paulvee/100MHz-Differential-Probe/Diff Probe Front detail.jpg

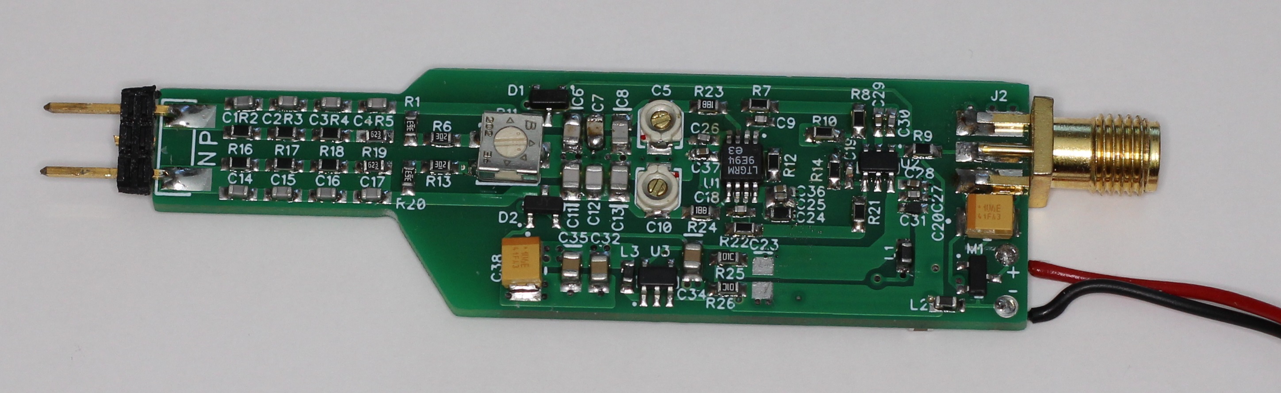
Diff Probe Front detail.jpg
