paulvee/100MHz-Differential-Probe/Diff Probe Back.jpg

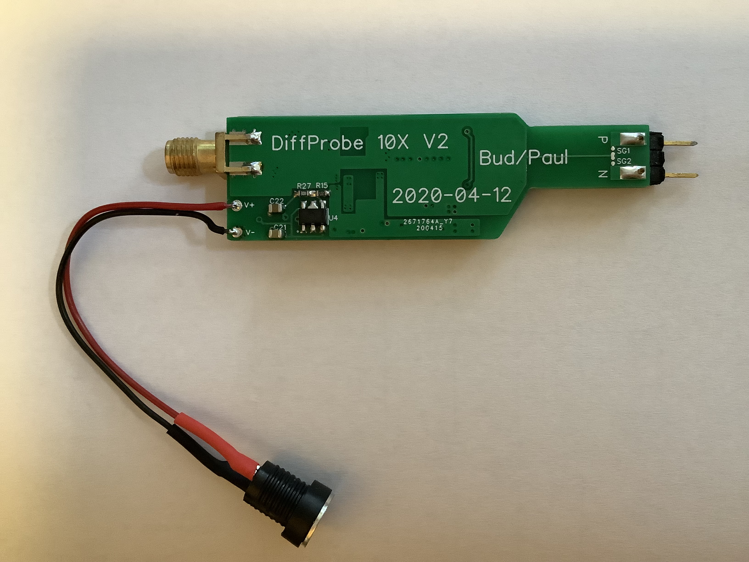
Diff Probe Back.jpg
