paulvee/100MHz-Differential-Probe/README.md

# 100MHz-Differential-Probe
100 MHz Differential Probe V2

There is a new and updated design for this probe!
https://github.com/paulvee/New-Differential-Probe-1-10-100MHz

The description of this project can be found on my blog : 
https://www.paulvdiyblogs.net/2017/10/differential-amplifier-probe-make-buy.html
and also on Bud Bennets blog:
https://hackaday.io/project/169390-a-10x-100mhz-differential-probe/details
Bud is the father of the differential probe design.

There are two versions of the same probe, one specifically tuned for the use of 240V. This is the version documented here. It also has a different power supply so standard 5V USB wall warts can be used.
The one Bud designed has a different power supply and is designed for 115V main supplies.
