paulvee/100MHz-Differential-Probe/Schematic V2.jpg

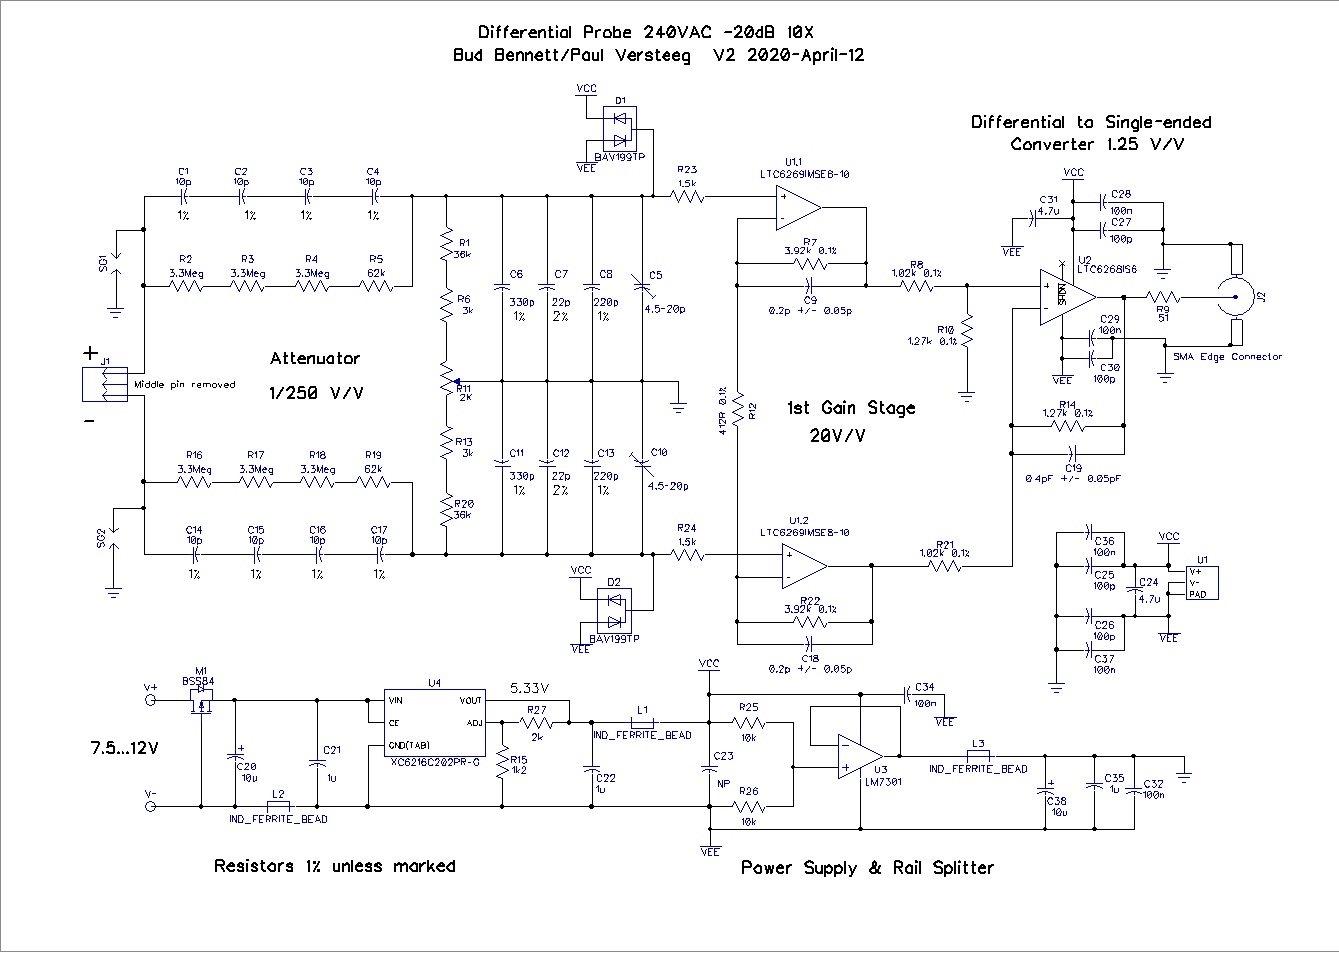
Schematic V2.jpg
