paulvee/100MHz-Differential-Probe/Diff Probe BOM V3b.xlsx

Manufacturer Part Number | Manufacturer | Digi-Key Part Number | Customer Reference | Quantity | Unit Price | Extended Price | Description
GRM1885C1H220GA01D | Murata Electronics | 490-11451-1-ND | C7, C12 (Note1) | 2 | 0.01000 | € 0,20 | CAP CER 22PF 50V C0G/NP0 0603
CC0805FRNPO9BN331 | Yageo | 311-4176-1-ND | C6, C11 (Note1) | 2 | 0,28000 | € 0,56 | CAP CER 330PF 50V NPO 0805
CC0805FRNPO9BN221 | Yageo | 311-4172-1-ND | C8, C13 (Note1) | 2 | 0,28000 | € 0,56 | CAP CER 220PF 50V NPO 0805
GJM1555C1HR20WB01D | Murata Electronics | 490-11247-1-ND | C9, C18 | 2 | 0,27000 | € 1,08 | CAP CER 0.2PF 50V C0G/NP0 0402
GJM1555C1HR40WB01D | Murata Electronics | 490-11249-1-ND | C19 | 1 | 0,27001 | € 0,54 | CAP CER 0.4PF 50V C0G/NP0 0402
TAJB106K025RNJ | AVX Corporation | 478-5257-1-ND | C20, C38 (note4) | 2 | 0,59000 | € 1,18 | CAP TANT 10UF 10% 25V 1411 - 3528 Tantalum 2.5Ohm ESR
BAV199-TP | Micro Commercial Co | BAV199-TPMSCT-ND | D1, D2 | 2 | 0,22000 | € 0,88 | DIODE ARRAY GP 70V 215MA SOT23
MPZ1608S102ATA00 | TDK Corporation | 445-8694-1-ND | L1, L2, L3 | 3 | 0,07200 | € 1,08 | FERRITE BEAD 1 KOHM 0603 1LN
ERA-3AEB3921V | Panasonic Electronic Components | P3.92KDBCT-ND | R7, R22 | 2 | 0,31000 | € 0,62 | RES SMD 3.92KOHM 0.1% 1/10W 0603
ERA-3AEB1271V | Panasonic Electronic Components | P1.27KDBCT-ND | R10, R14 | 2 | 0,31000 | € 0,62 | RES SMD 1.27KOHM 0.1% 1/10W 0603
ERA-3AEB1021V | Panasonic Electronic Components | P1.02KDBCT-ND | R8, R21 | 2 | 0,31000 | € 0,62 | RES SMD 1.02KOHM 0.1% 1/10W 0603
3314J-1-202E | Bourns Inc. | 3314J-202ECT-ND | R11 | 1 | 1,99000 | € 1,99 | TRIMMER 2K OHM 0.25W J LEAD TOP
ERA-3AEB4120V | Panasonic Electronic Components | P412DBCT-ND | R12 | 1 | 0,31000 | € 0,31 | RES SMD 412 OHM 0.1% 1/10W 0603
LTC6269IMS8E-10#PBF | Linear Technology/Analog Devices | LTC6269IMS8E-10#PBF-ND | U1 | 1 | 12,47000 | € 12,47 | IC OPAMP GP SGL FET 8MSOP
LTC6268IS6#TRMPBF | Linear Technology/Analog Devices | LTC6268IS6#TRMPBFCT-ND | U2 | 1 | 7,90000 | € 7,90 | IC OPAMP GP 1 CIRCUIT TSOT23-6
JR200 | Knowles Voltronics | 1674-1019-1-ND | C5, C10 (Note1, Note2) | 2 | 3,95000 | € 7,90 | CAP TRIMMER 4.5-20PF 125V SMD 300ppm 3mm 1/2 turn
06032U100GAT2A | AVX Corporation | 478-10251-1-ND | C1-C4 C14-C17 | 8 | 0,23300 | € 2,33 | CAP CER 10PF 1% 200V NP0 0603
XC6216C202PR-G | Torex Semiconductor Ltd | 893-1080-1-ND | U4 | 1 | 0,94000 | € 3,76 | IC REG LIN POS ADJ 100MA SOT89-5
BSS84 | ON Semiconductor | BSS84CT-ND | M1 (Note5) | 1 | 0,30000 | € 1,80 | MOSFET P-CH 50V 130MA SOT-23
CRGCQ0603F1K2 | TE Connectivity Passive Product | A129689CT-ND | R15 | 1 | 0,02700 | € 0,27 | CRGCQ 0603 1K2 1%
RC0603FR-072KL | Yageo | 311-2.00KHRCT-ND | R27 | 1 | 0,02100 | € 0,21 | RES SMD 2K OHM 1% 1/10W 0603
CL05A475MP5NRNC | Samsung Electro-Mechanics | 1276-1482-1-ND | C24, C31 (Note 6) | 2 | 0,09000 | €0.18 | CAP CER 4.7UF 20% X5R 10V 0402
C0402C101K5GACTU | KEMET | 399-7750-1-ND | C25, C26, C27, C30 | 4 | 0,02900 | € 0,29 | CAP CER 100PF 50V C0G/NP0 0402
GRM155R62A104KE14D | Murata Electronics | 490-10458-1-ND | C28, C29, C36, C37 | 4 | 0,03600 | € 0,36 | CAP CER 0.1UF 100V X5R 0402
RMCF0603FT62K0 | Stackpole Electronics Inc | RMCF0603FT62K0CT-ND | R5, R19 | 2 | 0,01500 | € 0,15 | RES 62K OHM 1% 1/10W 0603
CRCW06033M30FKEA | Vishay Dale | 541-3.30MHCT-ND | R2-R4, R16-18 | 6 | 0,03100 | € 0,31 | RES SMD 3.3M OHM 1% 1/10W 0603
RC0603FR-0736KL | Yageo | 311-36.0KHRCT-ND | R1, R20 | 2 | 0,02100 | € 0,21 | RES SMD 36K OHM 1% 1/10W 0603
RC0603FR-073KL | Yageo | 311-3.00KHRCT-ND | R6, R13 | 2 | 0,02100 | € 0,21 | RES SMD 3K OHM 1% 1/10W 0603
CRCW060350R0FKEA | Vishay Dale | 541-3318-1-ND | R9 | 1 | 0,03600 | € 0,36 | RES SMD 50 OHM 1% 1/10W 0603
RC0603FR-071K5L | Yageo | 311-1.50KHRCT-ND | R23, R24 | 2 | 0,02100 | € 0,21 | RES SMD 1.5K OHM 1% 1/10W 0603
RC0603FR-0710KL | Yageo | 311-10.0KHRCT-ND | R25, R26 | 2 | 0,02100 | € 0,21 | RES SMD 10K OHM 1% 1/10W 0603
LM7301IM5X/NOPB | Texas Instruments | LM7301IM5X/NOPBCT-ND | U3 | 1 | 2,26000 | € 2,26 | IC OPAMP GP 1 CIRCUIT SOT23-5
0603B105K100XD | Yageo | 311-1445-1-ND | C21, C22 | 2 |  |  | CAP CER 1UF 25V X5R 0603
CC0805KKX7R7BB105 | Yageo | 311-1365-1-ND | C35 | 1 |  |  | CAP CER 1UF 16V X7R 0805
CC0805KRX7R7BB104 | Yageo | 311-1142-1-ND | C32, 34 | 2 |  |  | CAP CER 0.1UF 16V X7R 0805
 |  |  | C23 | 1 |  |  | DNP
RF2-143-T-17-50-G | Adam Tech (https://nl.mouser.com/manufacturer/adam-tech/) | 2057-RF2-143-T-17-50-G-ND | J2 | 1 |  |  | 6.45mm Board Edge Female SMA | generic | https://www.aliexpress.com/item/32779564868.html?spm=a2g0s.9042311.0.0.40a64c4dDmQTXO
GRM1885C1H270GA01D | Murata Electronics | 490-11455-1-ND | extra for tuning C7, C12 | 2 | 0,09000 | € 0,36 | CAP CER 27PF 50V C0G/NP0 0603
GRM1885C1H180GA01D | Murata Electronics | 490-11449-1-ND | extra for tuning C7, C12 | 2 | 0,09000 | € 0,36 | CAP CER 18PF 50V C0G/NP0 0603
GJM1555C1HR30WB01D | Murata Electronics | 490-11248-1-ND | extra for tuning C19 | 1 | 0,27001 | € 0,54 | CAP CER 0.3PF 50V C0G/NP0 0402
GJM1555C1HR20WB01D | Murata Electronics | 490-11247-1-ND | extra for tuning C19 | 1 | 0,27000 | € 1,08 | CAP CER 0.2PF 50V C0G/NP0 0402
I strongly suggest you order a few extras for all the 0402 parts when you use a heat-gun, they have the nasty habbit to dissapear without a trace.
GRM1885C1H270GA01D | CAP CER 27PF 50V C0G/NP0 0603 |  | C7, C12 alternative
Note1: The sum of these capacitors should be 575pF if using the source for 10pF input caps. Be prepared to change C7/C12 value if the AC gain can't be adjusted to the correct value with C5 and C10.
Note2: Can use JR200 a 4.5-20pF trimmer to get more range, but poorer tempco.
Note3: Can use any SOT23-5 opamp for U3 with same pinout and Vos <5mV and operates with 5.0V supply
Note4: Must have ESR =< 2.5Ω. Alternate source: https://www.digikey.com/product-detail/en/avx-corporation/TAJB106K025RNJ/478-5257-1-ND/1950924
Note5: Can use any logic level PCH FET with RDSon < 1Ω (the lower the better); As an example AO3401A (60mOhm).
Note 6: 0402 Tantalum is hard to find, but there is a Tantalum Poly available from Digikey : 478-10032-1-ND, when you use a X5R, use a 10uF version
