paulvee/100MHz-Differential-Probe/(list of files, drawings)

Other design files:
Diff Probe 240V PV2/DiffProbe240PV2.dch
Diff Probe 240V PV2/DiffProbePV2.dip
