paulvee/100MHz-Differential-Probe/(threads)

Thread 1 (2020-04-30):

Gerber

iskralpust, 2020-04-30:
Hi I see you have removed the Gerber files for this project. Are you adding new files? It would also be super great is you can add the Diptrace-Eagle files. Thanks.

paulvee, 2020-05-01:
Yes I did. I wanted to verify the new layouts before I posted the Gerbers. The boards just arrived and I will be adding the components and start testing. very soon. Keep an eye on my blog for this project.

iskralpust, 2020-05-02:
Awesome looking forward to hearing how it turns out.

iskralpust, 2020-05-17:
Hi is there any chance you can upload the board and schematic files I was going to make some modifications to the board dimensions for an enclosure and add a 9v battery holder and pcb mount power switch.

paulvee, 2020-05-17:
iskralpust,
At this moment we do not want to publish more details, in fear that somebody will copy our design and turn it into a commercial product and sell it without us benefiting. This has happened before as you will probably know.

Closed 2020-05-18.

Thread 2 (2020-05-18):

Differential voltage range

iskralpust, 2020-05-18:
Hi I saw a comment that you made about how easy it would be to set the gain by changing the 20v/v stage by varying r12. Have you tried or simulated 2v/v to get x100 probe. The diode protection would probably need to be 2 in series for 1.4v clamping this would be well within input voltage range of the first stage assuming the rails are +-2.66v. It would cause some clipping if you exceed 2vpp into the first gain stage but that seems fine as it would not be able to damage anything if its clamped at 1.4v. Thanks.

paulvee, 2020-05-18:
No, I didn't, but maybe my friend Bud did. He's much better at this than I am, I suggest you ask him.

Closed 2024-10-08.

Thread 4 (2021-04-18):

.CPL Pick and Place file?

bepstein111, 2021-04-18:
Would it be possible to provide a .CPL pick and place file? I'm looking to get one or two of these made up with pcbway, and they need a pick and place file. Thanks for your time!

paulvee, 2021-04-19:
Yes, Diptrace supports Pick & Place, but not in a .CPL file, but a .CSV file.
See if you can use that.

Success!
Paul

[PickandPlace.zip](https://github.com/paulvee/100MHz-Differential-Probe/files/6336672/PickandPlace.zip)

.

Closed 2024-10-08.

Thread 5 (2021-06-14):

wrong opamp in BOM

shailen001, 2021-06-14:
Hi,
I just put this probe together. All seems to work except with both terminals connected together, I'm getting x2-x4 noise.

I think the problem might be the OPAMP in the BOM.

You say LTC6269IMS8E-10, but is it meant to be the lower bandwidth one like in some discussion in blog?

If so, please fix your BOM or others.

Thanks.

shalingb, 2021-06-14:
Sorry, that can't be my issue. Only applies to x1 probe. x10 should be OK.

paulvee, 2021-06-14:
The Opamp as listed in the BOM is correct, and the ONLY one to be used.

Closed 2024-10-08.

Thread 6 (2024-03-22):

SMA Edge Connector?

bepstein111, 2024-03-22:
Hi There-
Great project, I had one made a while back and am just getting around to testing it out, love the project. Quick question, I don't see the SMA edge connector on the BOM, wondering where you sourced yours. It looks like the pinout is a 5-pin, but I can only find square 4-pin edge connectors. Perhaps I'm looking for the wrong thing. Any insight would be helpful!

Thanks!

Thread 7 (2024-10-07):

Diff Probe BOM V3.xlsx

wocard2, 2024-10-07:
Thanks for the notes in the new BOM file!

About note 1: "resistors" should be replaced with "capacitors"

Note 3 is unreferenced, probably refers to U3. Isn't some minimum output current for U3 required?

About note 4: really exactly equal? Or would a smaller ESR be okay?

Note 6 is unreferenced.

About note 7: the 0402 footprints are extremely large (0402 components barely touch the pads), 0603 components can be easily hand-soldered onto them. Even 0805 tantalum capacitors  could be used for C24 and C31 as those have only one neighbor and suffer the most from their tiny size.

paulvee, 2024-10-08:
Hi wocard2,
Thank you for the inputs, you caught a few more.
I fixed 1, 3, 4, added J2 and deleted 6.
7 is now 6. About size 0402 (1005 Metric), it is listed as 0.043" L x 0.024" W (1.10mm x 0.60mm). There are many 0402 parts on the board, so I think you are looking at the wrong specification for 0402.
I updated the BOM file.

wocard2, 2024-10-08:
Here's the ocular proof (please excuse the poor image quality):
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
I placed a 0805 (imperial) resistor on the C24 footprint (yes, it's too wide, but that works if there is only one neighbor) , a 0603 (imperial) resistor on the C25 footprint, and a 0402 (imperial) resistor on the C36 footprint. All these footprints are supposed to be 0402 (imperial) footprints. As you can see, a 0603 or even a 0805 capacitor can be used for C24. The advantage, besides availability, is a much smaller ESR. Those 0402 (imperial) footprints look like 0603 (imperial) footprints to me.

wocard2, 2024-10-08:
Any requirements for the minimum output power of U3?

paulvee, 2024-10-08:
U3 only supplies the common ground, a few mA should do. Look at the LM7301 datasheet for guidance.
I uploaded two pictures of my probe that will show the sizes of the parts I used, which are specified in the BOM.

wocard2, 2024-10-08:
Thanks for the great images! Whatever equiment I use for taking photoghraphs, the result will be mediocre.

The image of the front side clearly shows that the footprint of C26 is too big (or that the component is too small). That could explain the tombstoning you experienced. That image also shows that your C24 is bigger than 0402. Looks like 0603. You might want to mention in the BOM that 0603 components will fit on those 0402 footprints, in particiular for C24 and C31.

wocard2, 2024-10-21:
Note that the CL05A475MP5NRNC listed for C24 and C31 in the V3a BOM has only 1.1 µF at 5.35 V DC. 0603 MLCCs are better than 0402 MLCCs w.r.t. DC bias...

paulvee, 2024-11-03:
There is a Tantalum Poly available from Digikey : 478-10032-1-ND.
When you use an X5R, use a 10uF version

Closed 2024-10-08.

Thread 8 (2024-10-10):

M1

wocard2, 2024-10-10:
I found no version of the BSS84 that has a typical (not to mention a maximum) RDSon below 1Ω (at VGS=-10V, let alone at VGS=-7.5V) as required by note 5. For the BSS84 specimen mentioned in the BOM, RDSon is specified for VGS=-5V only, with a maximum value of 10Ω at 25°C.

An additional requirement for M1 is a maximum VGS of ±12 V or better. That's not mentioned by note 5.

For a maximum VGS of ±20 V or better (to add some margin of safety), choices for P-channel MOSFETS with low RDSon are very limited. It might be better to use an N-channel MOSFET on V- instead of a P-channel MOSFET on V+.

paulvee, 2024-10-11:
DigiKey has more than 60.000 of the BSS84 in stock. LCSC has 5600+ in stock.

wocard2, 2024-10-11:
Perhaps I was not clear enough. There are two issues:
(1) the BSS84 does not meet the requirement you impose on substitutions for the BSS84
(2) there's a requirement (on VGS) missing. For instance, the AO3435 would work according to note 5, but it will blow up.

wocard2, 2024-10-11:
In fact, I used an AO3435 but noticed the problem before applying power.

paulvee, 2024-10-11:
Bud uses an AO3401 in his probe.

wocard2, 2024-10-11:
I'm now also using an AO3401A. It's a bit risky as its absolute maximum value for VGS is ±12V. At least, it has a better RDSon than the BSS84.
