paulvee/100MHz-Differential-Probe/(commit log)

2020-05-05 Add files via upload
    Corrected one part-number and added a few missing parts
    [Diff Probe BOM V2.xlsx]
2023-07-29 Add files via upload
    Here are the DipTrace files for my Version 2 with the changes for the 240V input.
    [DiffProbe240PV2.dch, DiffProbePV2.dip]
